guiguima1202/drainwatch/docs/README.md

# Documentação do projeto

- `arquitetura.png`: diagrama de blocos do sistema
- `esquematico_sensor.png`: ligação do sensor, do divisor de tensão e do sinal do relé
- `esquematico_potencia.png`: relé, bomba, diodo de proteção e capacitor
- `montagem.jpg`: foto da montagem do protótipo
- `testes/`: capturas de tela e fotos das evidências dos testes
