guiguima1202/drainwatch/docs/arquitetura.png

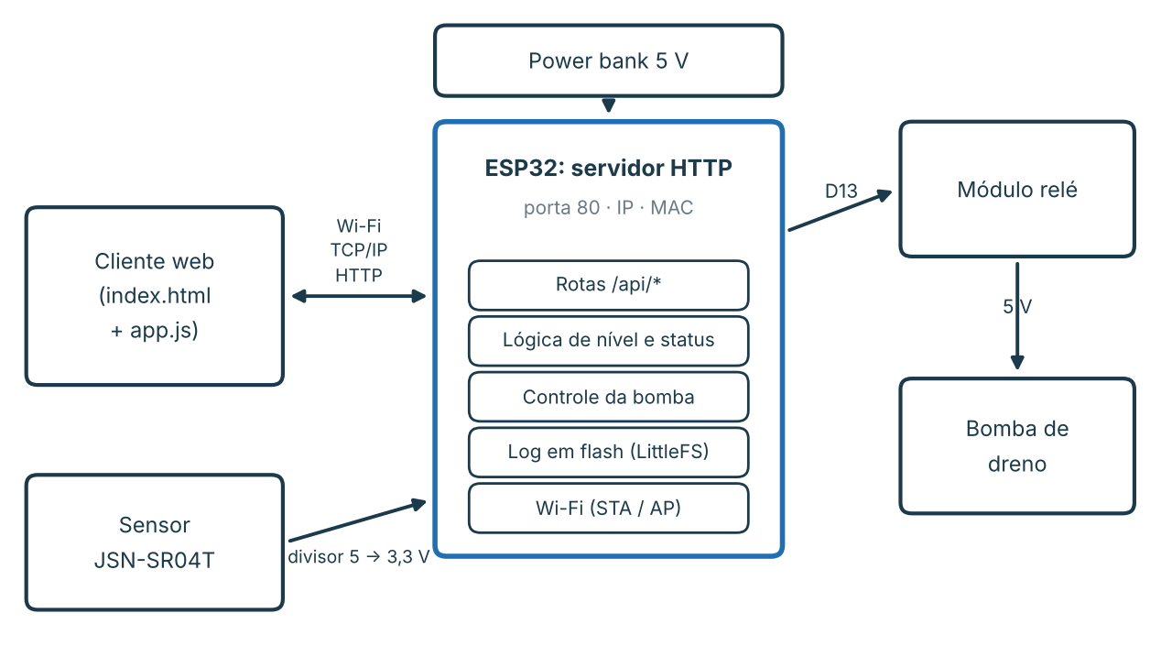
docs/arquitetura.png
