guiguima1202/drainwatch/docs/esquematico_potencia.png

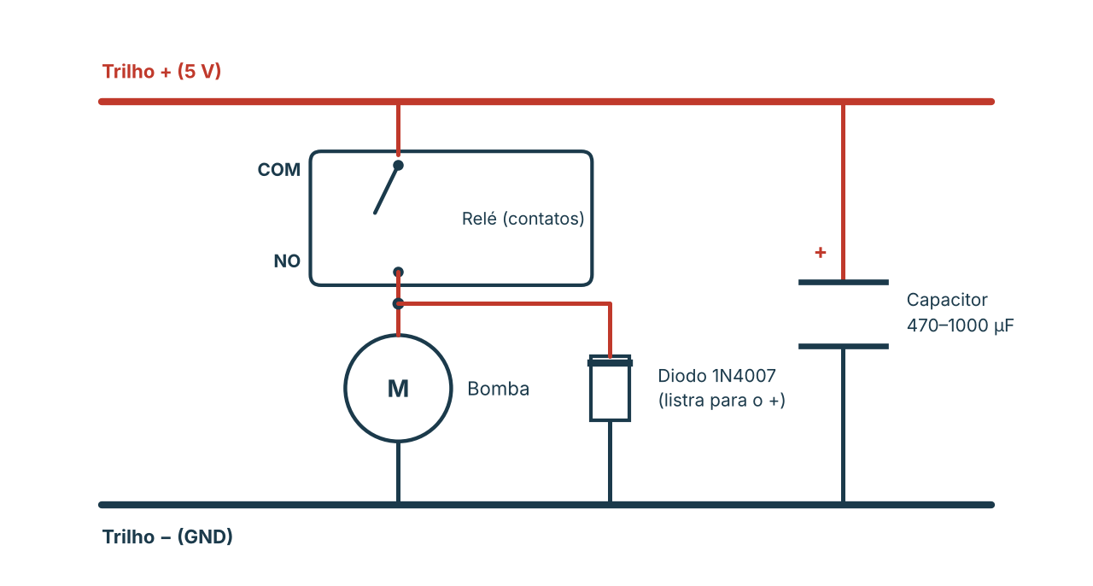
docs/esquematico_potencia.png
