guiguima1202/drainwatch/docs/esquematico_sensor.png

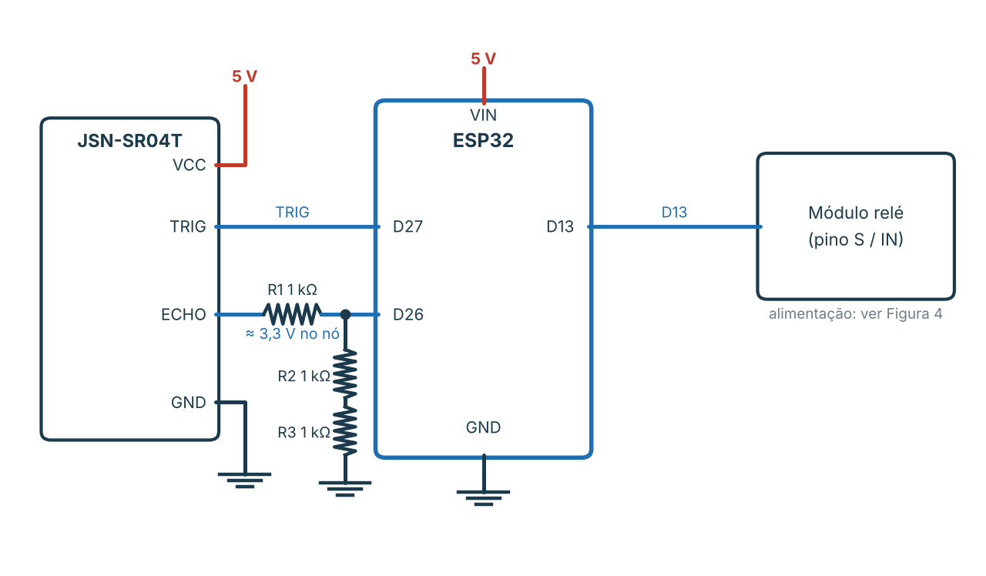
docs/esquematico_sensor.png
