guiguima1202/drainwatch/docs/testes/T1_ping.png

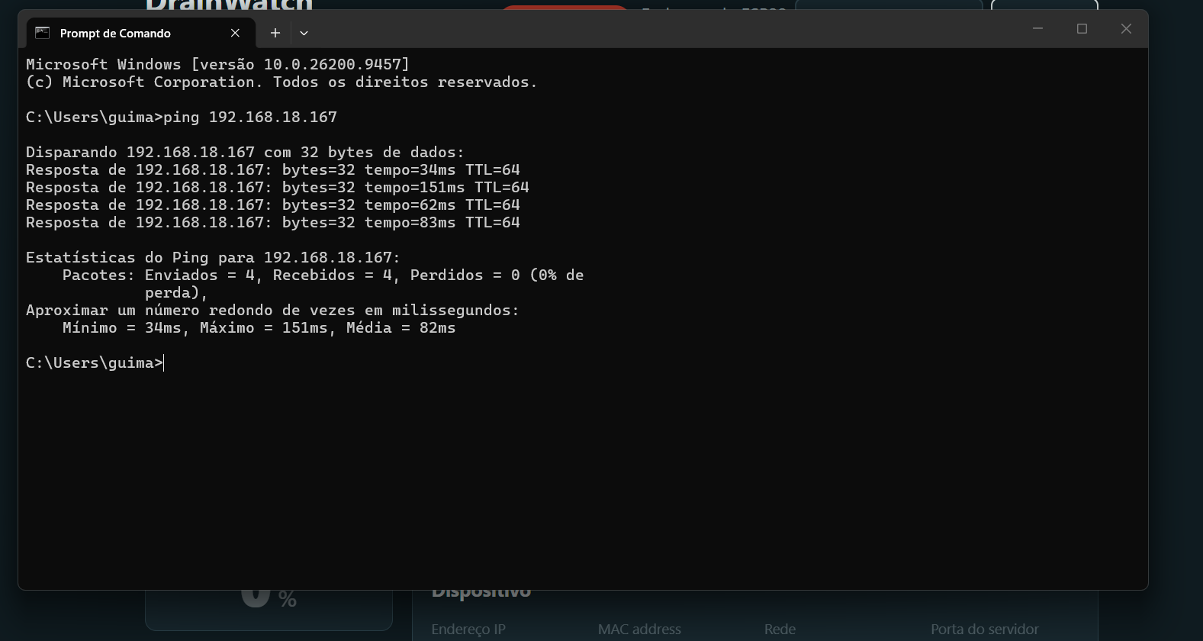
docs/testes/T1_ping.png
