guiguima1202/drainwatch/docs/testes/T2_porta80.png

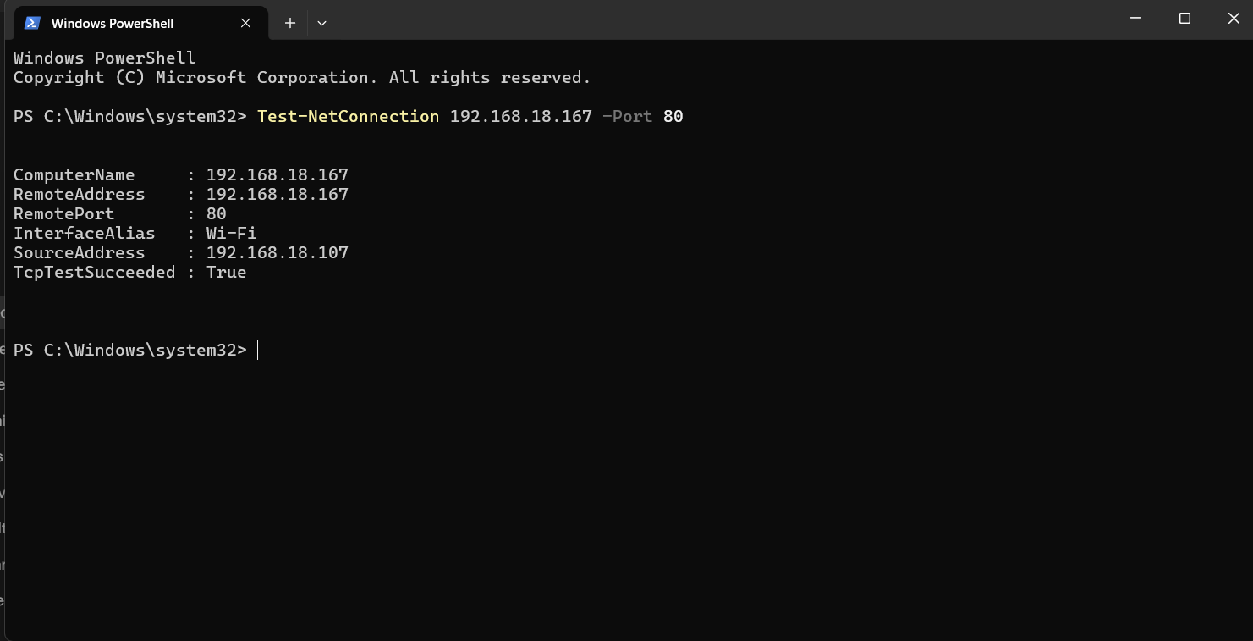
docs/testes/T2_porta80.png
