guiguima1202/drainwatch/docs/testes/T3_curl.png

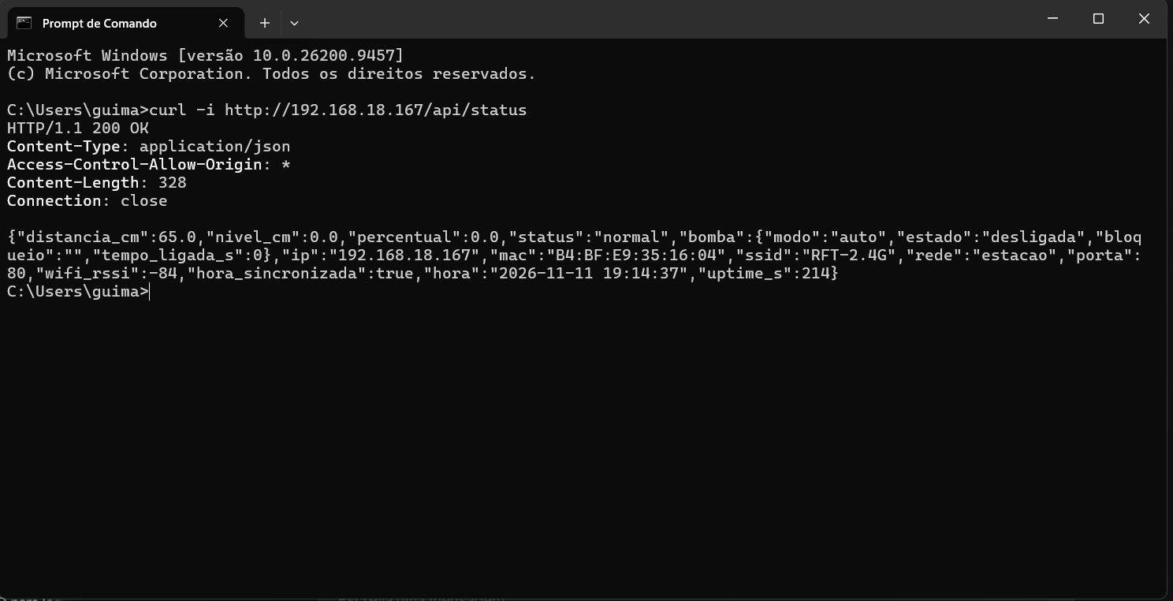
docs/testes/T3_curl.png
