guiguima1202/drainwatch/docs/testes/T4_pagina_38cm.jpg

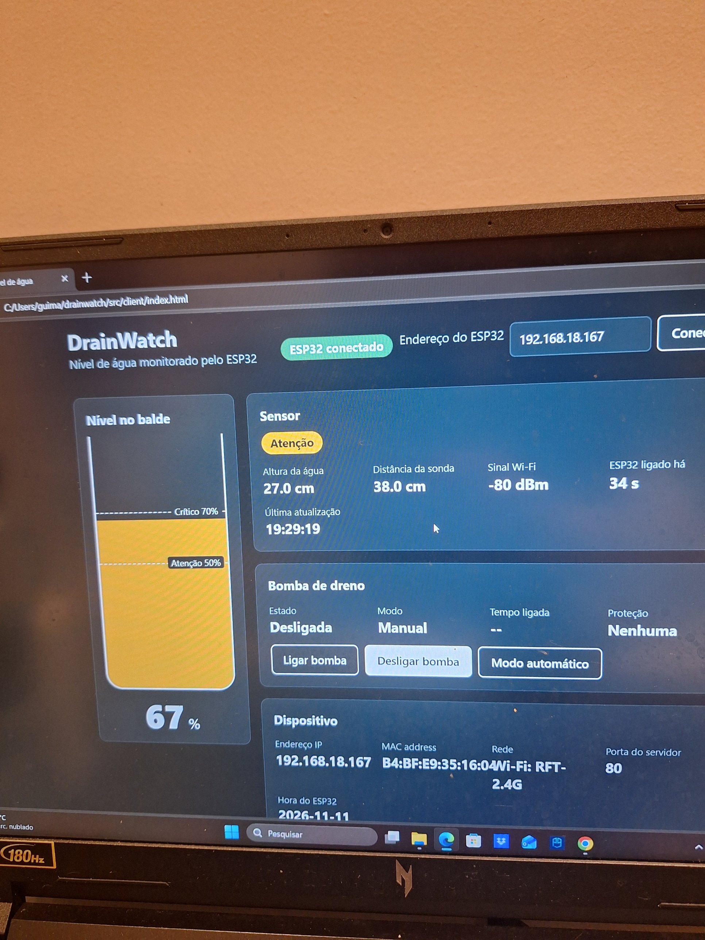
docs/testes/T4_pagina_38cm.jpg
