guiguima1202/drainwatch/docs/testes/T4_trena_38cm.jpg

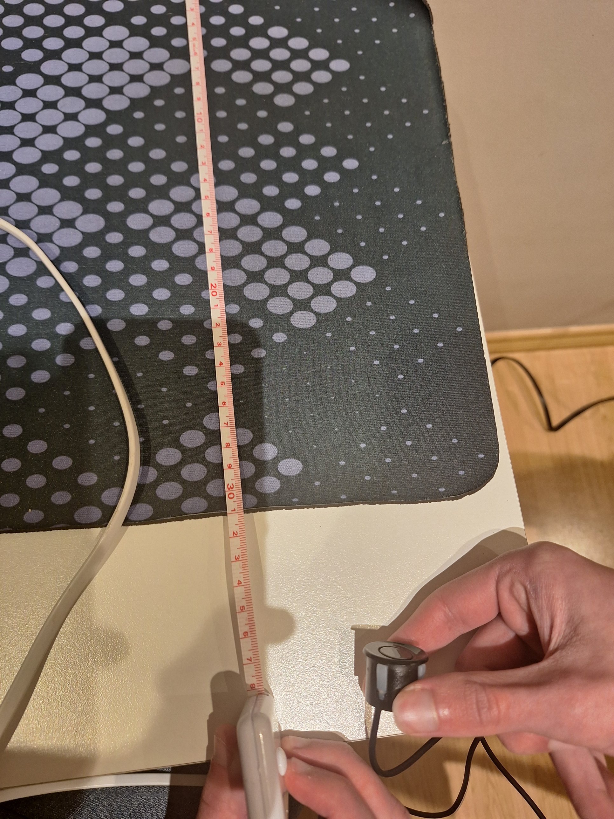
docs/testes/T4_trena_38cm.jpg
