guiguima1202/drainwatch/docs/testes/T5_bomba_em_funcionamento.jpg

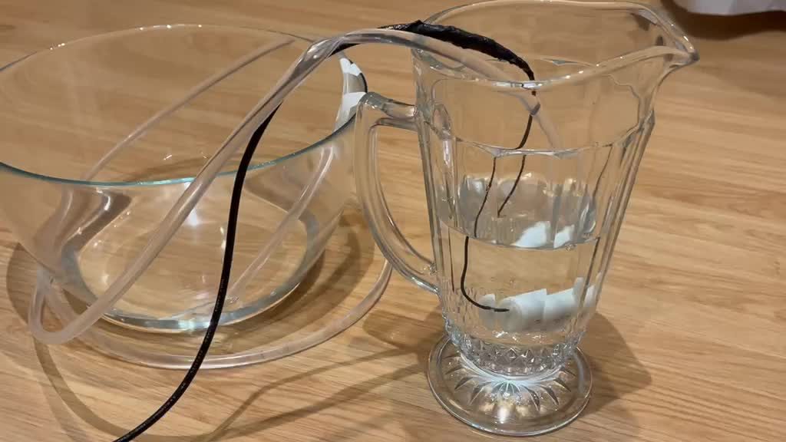
docs/testes/T5_bomba_em_funcionamento.jpg
