guiguima1202/drainwatch/docs/testes/T5_cliente_bomba_desligada.jpg

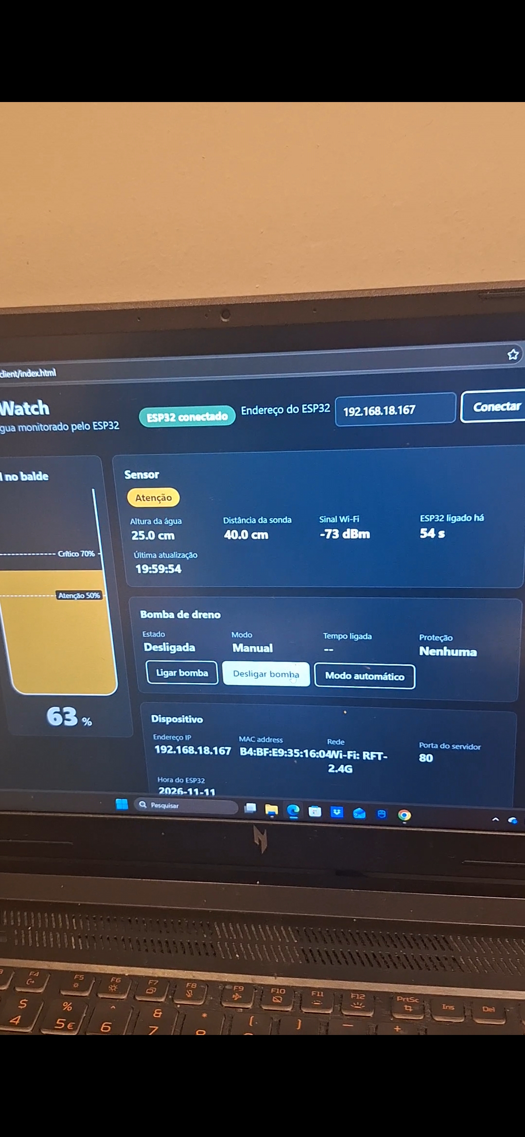
docs/testes/T5_cliente_bomba_desligada.jpg
