guiguima1202/drainwatch/docs/testes/T5_cliente_bomba_ligada.jpg

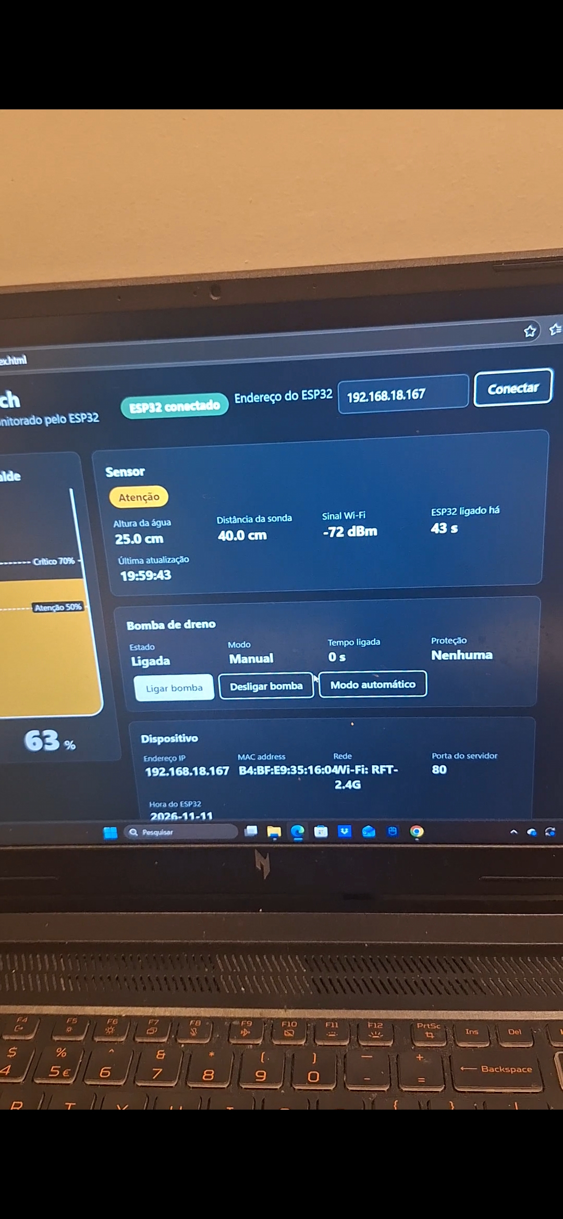
docs/testes/T5_cliente_bomba_ligada.jpg
