guiguima1202/drainwatch/docs/testes/T5_log_esp32.jpg

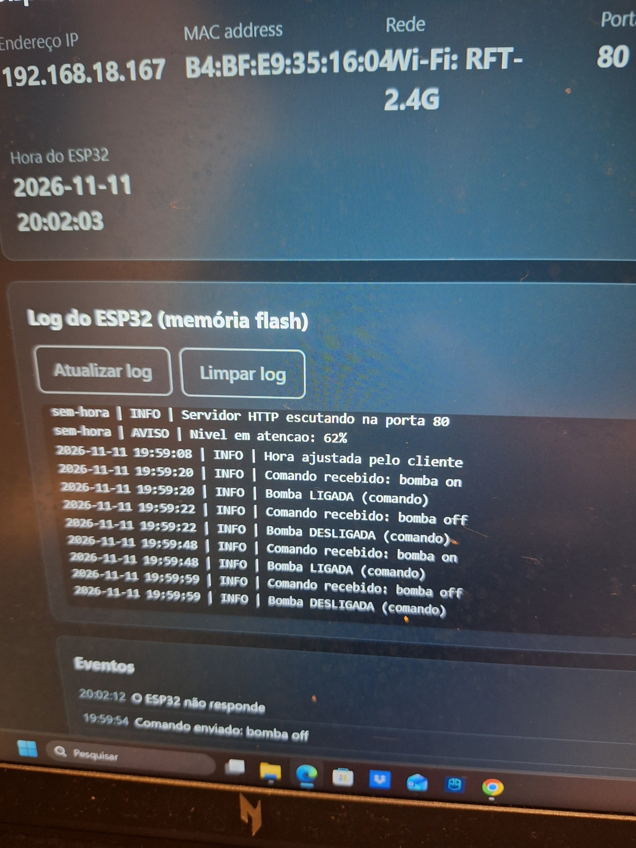
docs/testes/T5_log_esp32.jpg
